tennessee-garage/dB-Sentry/assets/tiki-1.png

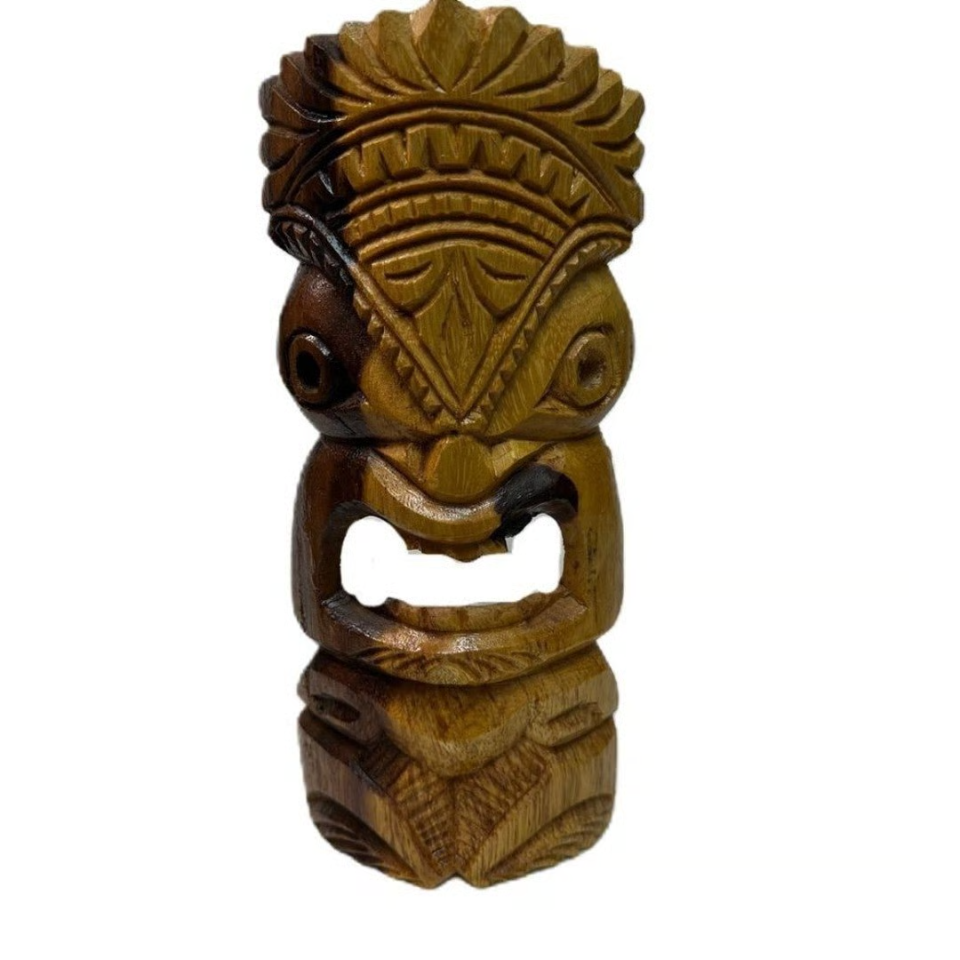
assets/tiki-1.png
