tennessee-garage/dB-Sentry/README.md

# dB-Sentry
Sound level monitoring, graphing and alerting for music events
