tennessee-garage/dB-Sentry/src/limit-service/README.md

# dB-Sentry Limit Service

A Python service for Raspberry Pi that:
- Subscribes to MQTT topics on the local broker and evaluates incoming numeric messages.
- Reads and writes limit values to InfluxDB on the Pi.
- Controls an LED strip (hardware mode) or simulates LED output (dev mode).
- Provides a simple HTTP UI to view and update 3-5 numeric limits.

Quick start

1. Install dependencies (on the Pi):

```bash
python3 -m venv venv
source venv/bin/activate
pip install -r requirements.txt
```

2. Create a `.env` file next to `main.py` with Influx/MQTT settings, e.g.:

```ini
MQTT_BROKER=localhost
MQTT_PORT=1883
MQTT_TOPIC=sensors/#
INFLUX_URL=http://localhost:8086
INFLUX_TOKEN=my-token
INFLUX_ORG=my-org
INFLUX_BUCKET=limits
LED_SIMULATE=true
LED_COUNT=30
``` 

3. Run locally:

```bash
python main.py
```

## MQTT debug CLI

Use this helper to print incoming level data from MQTT by sensor:

```bash
python monitor-levels.py
```

Useful options:

```bash
# custom connection/topic
python monitor-levels.py --broker localhost --port 1883 --topic "db_sentry/#"

# also display payloads that could not be parsed as numeric levels
python monitor-levels.py --show-unparsed
```

## Running as a systemd service

To run the service automatically on boot:

1. Install the service:

```bash
# Copy the service file to systemd
sudo cp db-sentry-limit.service /etc/systemd/system/

# Reload systemd to recognize the new service
sudo systemctl daemon-reload

# Enable the service to start on boot
sudo systemctl enable db-sentry-limit

# Start the service now
sudo systemctl start db-sentry-limit
```

2. Managing the service:

```bash
# Check status
sudo systemctl status db-sentry-limit

# View logs
sudo journalctl -u db-sentry-limit -f

# Stop the service
sudo systemctl stop db-sentry-limit

# Restart the service
sudo systemctl restart db-sentry-limit

# Disable auto-start on boot
sudo systemctl disable db-sentry-limit
```

**Note:** Make sure to update the `User`, `Group`, `WorkingDirectory`, and `ExecStart` paths in `db-sentry-limit.service` to match your system configuration before installing.

Files of interest
- `main.py` - entrypoint that starts MQTT, Influx and the web server.
- `mqtt_client.py` - MQTT subscription and message handling.
- `influx_client.py` - read/write limit values.
- `webserver.py` - FastAPI app exposing UI and update endpoints.

Notes
- InfluxDB: The project now prefers InfluxDB v1. Configure `INFLUX_HOST`, `INFLUX_PORT`, `INFLUX_USER`, `INFLUX_PASSWORD`, and `INFLUX_DB` in your `.env` to persist limits. If `INFLUX_DB` is not set or the v1 client is unavailable, the service will use an in-memory Noop client with default limits.
	The v2 `influxdb-client` settings (`INFLUX_URL`, `INFLUX_TOKEN`, `INFLUX_ORG`, `INFLUX_BUCKET`) remain in `.env.example` for legacy reference but are not used by default.
