tennessee-garage/dB-Sentry/pcb/db-collector/db-collector.step

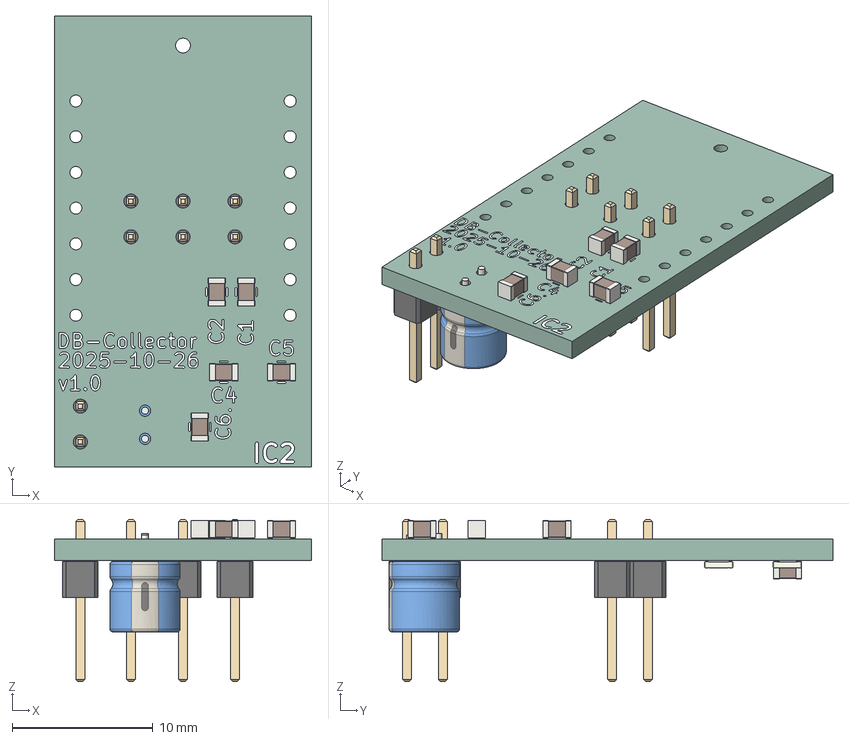
[picture p2: CAD file, 2025-12-04]
pcb/db-collector/db-collector.step
18.3 x 32.1 x 11.5 mm
C_0805_2012Metric x 6
PinHeader_1x02_P2.54mm_Vertical x 4
R_0805_2012Metric x 4
CP_Radial_D5.0mm_P2.00mm
db-collector_silkscreen
db-collector_PCB
