tennessee-garage/dB-Sentry/pcb/pi-battery-meter/pi-battery-meter.step

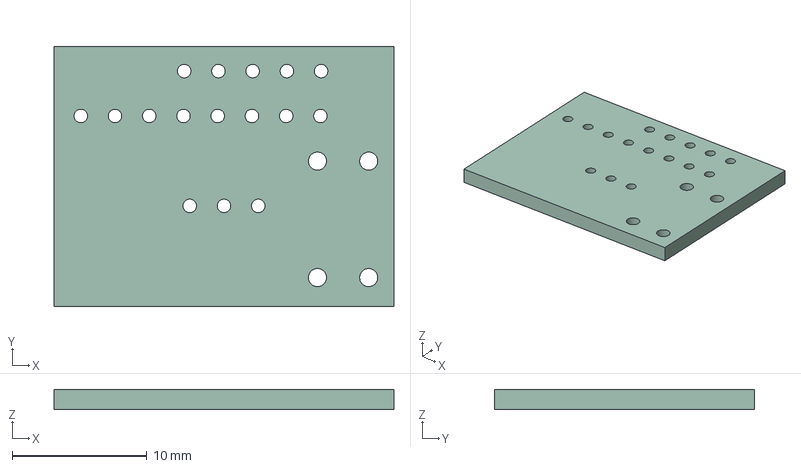
[picture p3: CAD file, 2026-04-11]
pcb/pi-battery-meter/pi-battery-meter.step
25.2 x 19.3 x 1.51 mm
