tennessee-garage/dB-Sentry/src/setup-service/IMPLEMENTATION_PLAN.md

# DB-Sentry Setup Service - Implementation Plan

## Overview
Raspberry Pi service that creates an Access Point for WiFi configuration of the DB-Sentry sensor network.

## Implementation Status: ✅ COMPLETE

### Components Implemented

#### 1. Configuration Management ✅
- **File**: `config_manager.py`
- **Settings File**: `config.json` (not tracked in git)
- **Features**:
  - AP SSID: "DB-Sentry-Setup"
  - AP Password: "not-too-loud"
  - Configurable network settings
  - JSON-based configuration

#### 2. Network Management ✅
- **File**: `network_manager.py`
- **Features**:
  - Start/stop AP mode using hostapd + dnsmasq
  - WiFi network scanning (nmcli + iwlist fallback)
  - Connect to WiFi networks
  - Network interface management

#### 3. API Endpoints ✅
- **File**: `app.py`
- **Endpoints**:
  - `POST /api/start-ap` - Enable AP mode
  - `POST /api/stop-ap` - Disable AP and connect to WiFi
  - `GET /api/scan-networks` - Scan for WiFi networks
  - `POST /api/configure-wifi` - Set WiFi credentials
  - `POST /api/sensor-register` - Register sensor and provide WiFi info
  - `GET /api/sensors` - List connected sensors
  - `GET /api/status` - Current setup status
  - `POST /api/reset` - Reset setup process

#### 4. Web Interface ✅
- **Files**: 
  - `templates/setup.html`
  - `static/style.css`
  - `static/script.js`
- **Features**:
  - Multi-step wizard interface
  - Network scanning and selection
  - Password entry
  - Real-time sensor registration display
  - Responsive design
  - Auto-refresh for sensor updates

#### 5. State Management ✅
- Tracks AP mode status
- Stores selected WiFi credentials
- Maintains list of connected sensors
- Setup completion tracking

## User Workflow

### Step 1: Start AP Mode
```bash
curl -X POST http://localhost:5000/api/start-ap
```

### Step 2: Connect to AP
- SSID: `DB-Sentry-Setup`
- Password: `not-too-loud`

### Step 3: Access Setup Page
- Navigate to: `http://192.168.4.1:5000`

### Step 4: Configure WiFi
1. Scan for networks
2. Select target WiFi
3. Enter password
4. Confirm

### Step 5: Register Sensors
Sensors make API call:
```python
response = requests.post('http://192.168.4.1:5000/api/sensor-register',
    json={'name': 'sensor-01'})
wifi_credentials = response.json()
```

### Step 6: Complete Setup
- Finish button stops AP
- Pi connects to configured WiFi
- System ready

## System Requirements

### Software
- Python 3.7+
- Flask 3.0.0
- flask-cors 4.0.0
- hostapd
- dnsmasq
- NetworkManager (nmcli)

### Hardware
- Raspberry Pi with WiFi
- WiFi adapter supporting AP mode

## Installation Steps

1. Install system packages:
```bash
sudo apt-get install hostapd dnsmasq python3-pip network-manager
```

2. Install Python dependencies:
```bash
pip3 install -r requirements.txt
```

3. Configure settings in `config.json`

4. Run service:
```bash
python3 app.py
```

## Security Notes

- `config.json` excluded from git via `.gitignore`
- AP password configurable
- WiFi credentials transmitted only over local network
- AP mode temporary (only during setup)

## Testing Checklist

- [ ] AP mode starts successfully
- [ ] Mobile device can connect to AP
- [ ] Setup page loads and displays correctly
- [ ] Network scan returns available WiFi
- [ ] WiFi credentials can be configured
- [ ] Sensors can register and receive credentials
- [ ] Setup completion stops AP
- [ ] Pi connects to configured WiFi

## Future Enhancements

- [ ] HTTPS support for setup page
- [ ] Sensor authentication tokens
- [ ] Multiple WiFi profile support
- [ ] Scheduled AP mode activation
- [ ] Email/SMS notifications
- [ ] Backup WiFi configuration
- [ ] Web UI for starting AP mode
- [ ] QR code for WiFi credentials

## Files Created

```
db-sentry-setup/
├── .gitignore              # Git ignore rules
├── README.md               # Documentation
├── IMPLEMENTATION_PLAN.md  # This file
├── app.py                  # Main Flask application
├── config.json            # Configuration (not in git)
├── config_manager.py      # Config management
├── network_manager.py     # Network utilities
├── requirements.txt       # Python dependencies
├── templates/
│   └── setup.html        # Web interface
└── static/
    ├── style.css         # Styles
    └── script.js         # Frontend JavaScript
```

## Notes

- Service runs on port 5000 by default
- AP IP: 192.168.4.1
- DHCP range: 192.168.4.2 - 192.168.4.20
- All settings configurable via config.json
