tennessee-garage/dB-Sentry/pcb/batt-interface/batt-interface.kicad_pcb

## KiCad design pcb/batt-interface/batt-interface.kicad_pcb (2026-10-09)

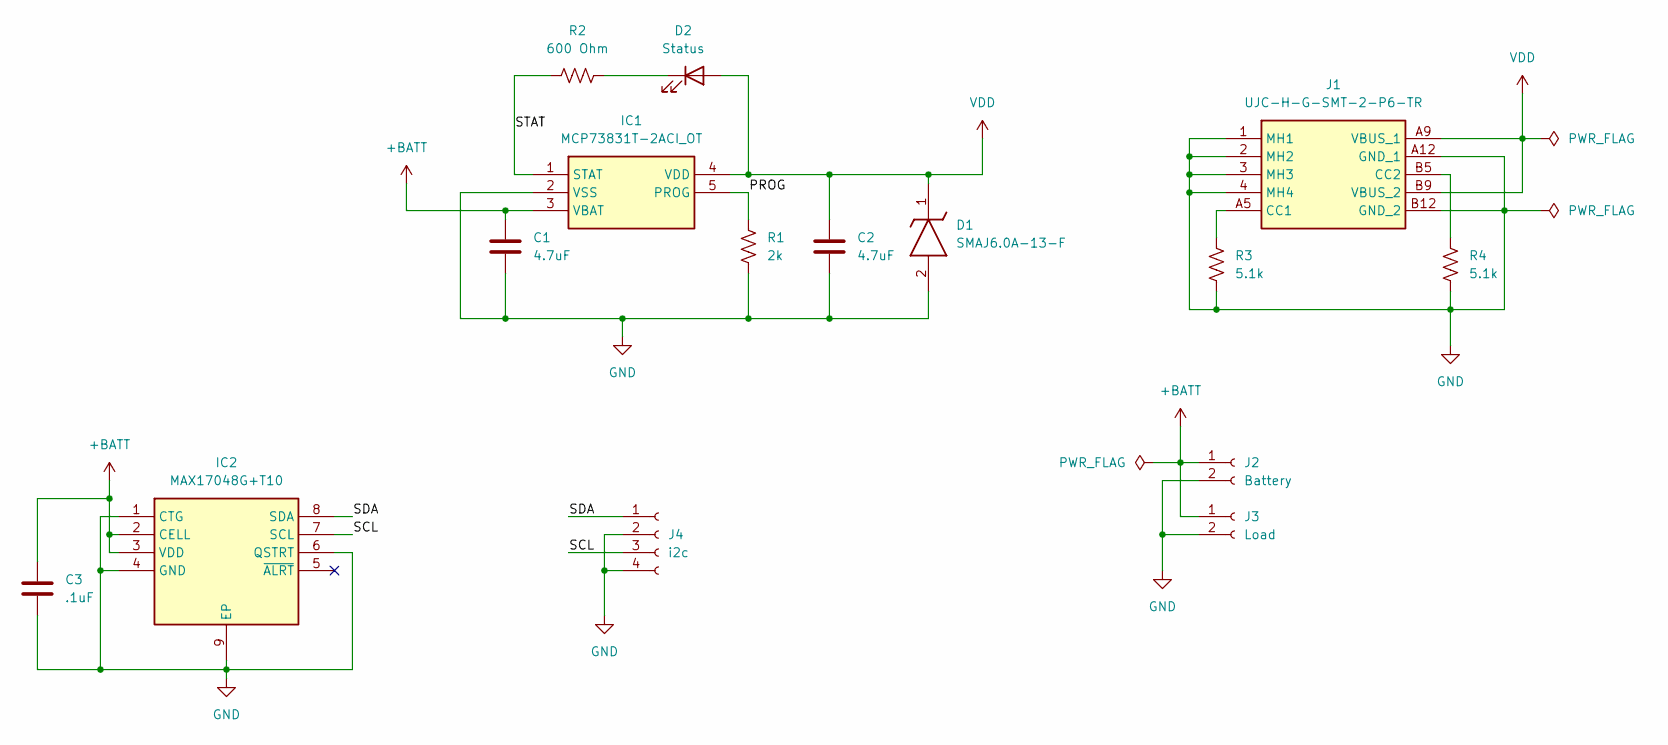
[picture p4: schematic batt-interface.kicad_sch]

Parts:
C1, C2: 4.7uF; C_0805_2012Metric_Pad1.18x1.45mm_HandSolder
C3: .1uF; C_0805_2012Metric_Pad1.18x1.45mm_HandSolder
D1: SMAJ6.0A-13-F; DIOM5226X240N; Mouser Part Number 621-SMAJ6.0A-13-F
D2: Status; LED_0805_2012Metric_Pad1.15x1.40mm_HandSolder
IC1: MCP73831T-2ACI_OT; SOT95P270X145-5N; Mouser Part Number 579-MCP73831T-2ACIOT
IC2: MAX17048G+T10; SON50P200X200X80-9N-D; Mouser Part Number 700-MAX17048G+T10
J1: UJC-H-G-SMT-2-P6-TR; UJCHGSMT2P6TR; Mouser Part Number 179-UJCHGSMT2P6TR
J2: Battery; JST_PH_S2B-PH-K_1x02_P2.00mm_Horizontal
J3: Load; JST_PH_S2B-PH-K_1x02_P2.00mm_Horizontal
J4: i2c; PinHeader_1x04_P2.54mm_Vertical
R1: 2k; R_0805_2012Metric_Pad1.20x1.40mm_HandSolder
R2: 600 Ohm; R_0805_2012Metric_Pad1.20x1.40mm_HandSolder
R3, R4: 5.1k; R_0805_2012Metric_Pad1.20x1.40mm_HandSolder

Connections:
+BATT: C1.1, C3.1, IC1.3 (VBAT), IC2.2 (CELL), IC2.3 (VDD), J2.1, J3.1
/PROG: IC1.5 (PROG), R1.1
/SCL: IC2.7 (SCL), J4.3
/SDA: IC2.8 (SDA), J4.1
/STAT: IC1.1 (STAT), R2.1
GND: C1.2, C2.2, C3.2, D1.2 (A), IC1.2 (VSS), IC2.1 (CTG), IC2.4 (GND), IC2.6 (QSTRT), IC2.9 (EP), J1.1 (MH1), J1.2 (MH2), J1.3 (MH3), J1.4 (MH4), J1.A12 (GND_1), J1.B12 (GND_2), J2.2, J3.2, J4.2, J4.4, R1.2, R3.2, R4.2
unnamed: D2.1 (K), R2.2
unnamed: J1.A5 (CC1), R3.1
unnamed: J1.B5 (CC2), R4.1
VDD: C2.1, D1.1 (K), D2.2 (A), IC1.4 (VDD), J1.A9 (VBUS_1), J1.B9 (VBUS_2)

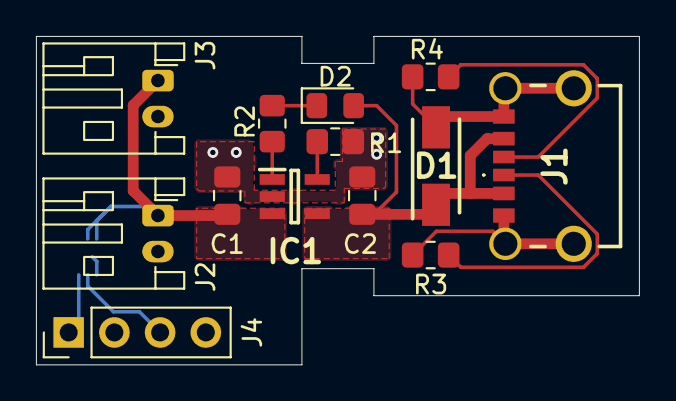
[picture p5: board batt-interface.kicad_pcb from above]

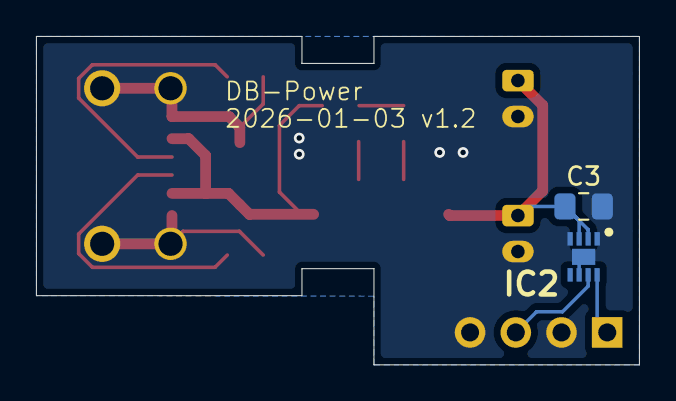
[picture p6: board batt-interface.kicad_pcb from below]

Board: 2 copper layers, 33.5 x 18.2 mm, 15 parts (2 on the bottom side), 10 nets.
