tennessee-garage/dB-Sentry/pcb/pi-shield/pi-shield.kicad_pcb

## KiCad design pcb/pi-shield/pi-shield.kicad_pcb (2026-04-30)

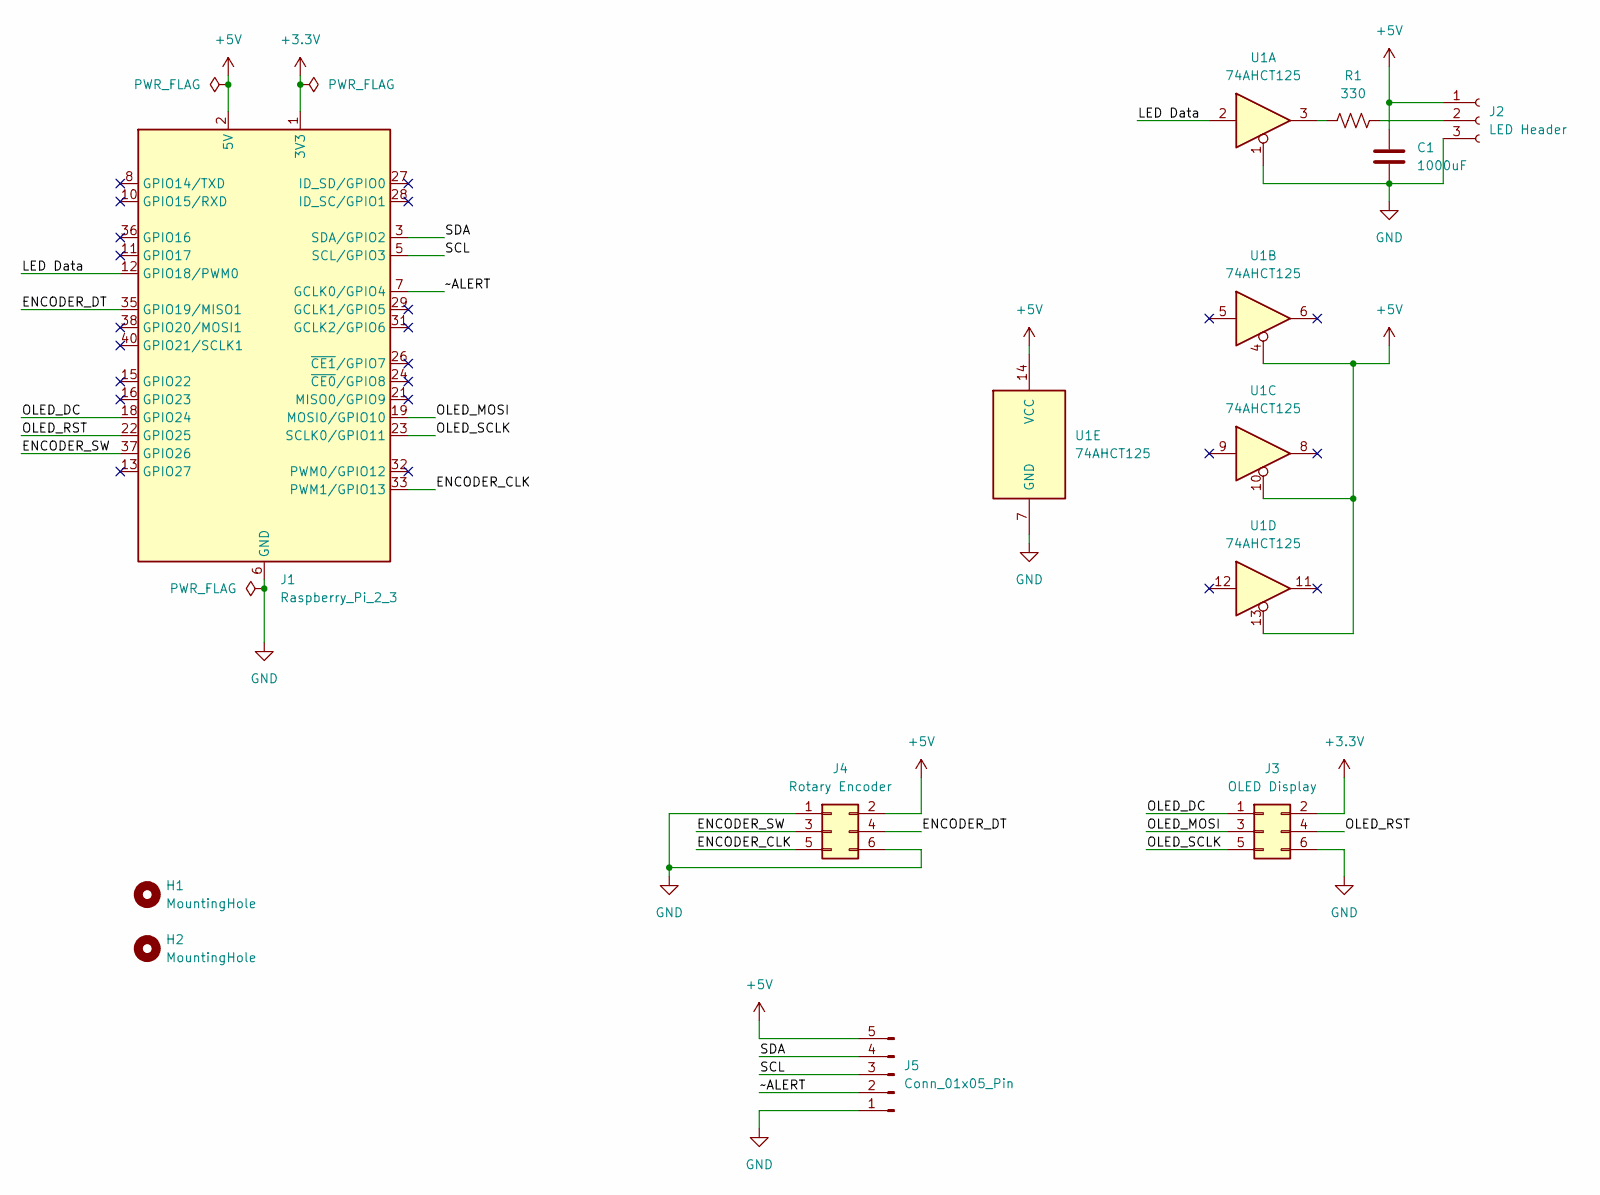
[picture p7: schematic pi-shield.kicad_sch]

Parts:
C1: 1000uF; C_Radial_D10.0mm_H16.0mm_P5.00mm
H1, H2: MountingHole; MountingHole_2.7mm_M2.5
J1: Raspberry_Pi_2_3; PinSocket_2x20_P2.54mm_Vertical
J2: LED Header; PinHeader_1x03_P2.54mm_Vertical
J3: OLED Display; PinHeader_2x03_P2.54mm_Vertical
J4: Rotary Encoder; PinHeader_2x03_P2.54mm_Vertical
J5: Conn_01x05_Pin; PinHeader_1x05_P2.54mm_Vertical
R1: 330; R_0805_2012Metric_Pad1.20x1.40mm_HandSolder
U1: 74AHCT125; TSSOP-14_4.4x5mm_P0.65mm

Connections:
+3.3V: J1.1 (3V3), J1.17 (3V3), J3.2
+5V: C1.1, J1.2 (5V), J1.4 (5V), J2.1, J4.2, J5.5, U1.4, U1.10, U1.13, U1.14 (VCC)
/ENCODER_CLK: J1.33 (PWM1/GPIO13), J4.5
/ENCODER_DT: J1.35 (GPIO19/MISO1), J4.4
/ENCODER_SW: J1.37 (GPIO26), J4.3
/LED Data: J1.12 (GPIO18/PWM0), U1.2
/OLED_DC: J1.18 (GPIO24), J3.1
/OLED_MOSI: J1.19 (MOSI0/GPIO10), J3.3
/OLED_RST: J1.22 (GPIO25), J3.4
/OLED_SCLK: J1.23 (SCLK0/GPIO11), J3.5
/SCL: J1.5 (SCL/GPIO3), J5.3
/SDA: J1.3 (SDA/GPIO2), J5.4
/~ALERT: J1.7 (GCLK0/GPIO4), J5.2
GND: C1.2, J1.6 (GND), J1.9 (GND), J1.14 (GND), J1.20 (GND), J1.25 (GND), J1.30 (GND), J1.34 (GND), J1.39 (GND), J2.3, J3.6, J4.1, J4.6, J5.1, U1.1, U1.7 (GND)
unnamed: J2.2, R1.2
unnamed: R1.1, U1.3

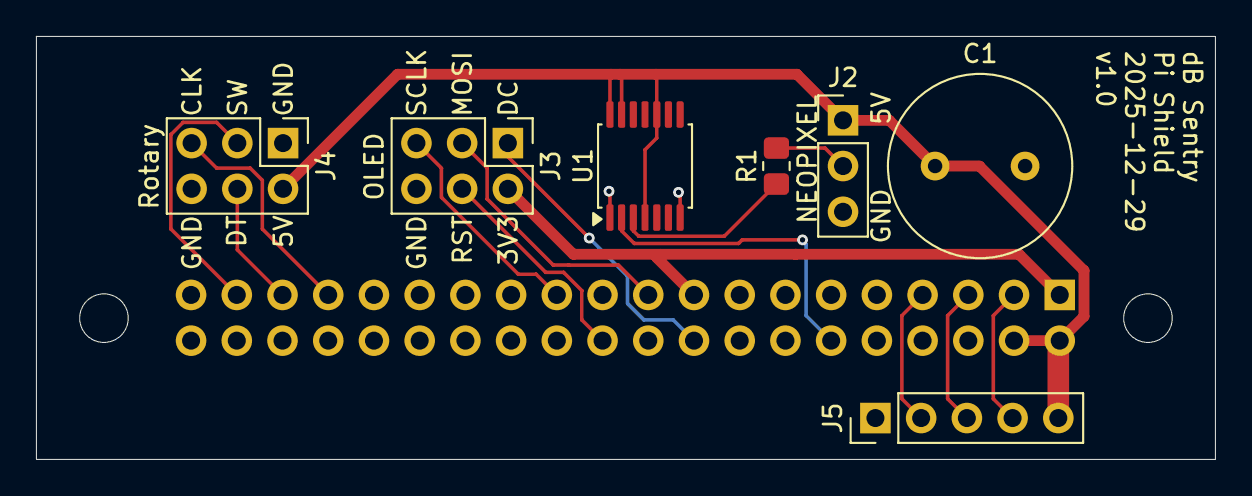
[picture p8: board pi-shield.kicad_pcb from above]

Board: 2 copper layers, 65.5 x 23.5 mm, 10 parts (1 on the bottom side), 16 nets.
