tennessee-garage/dB-Sentry/pcb/pi-battery-meter/pi-battery-meter.kicad_pcb

## KiCad design pcb/pi-battery-meter/pi-battery-meter.kicad_pcb (2026-04-11)

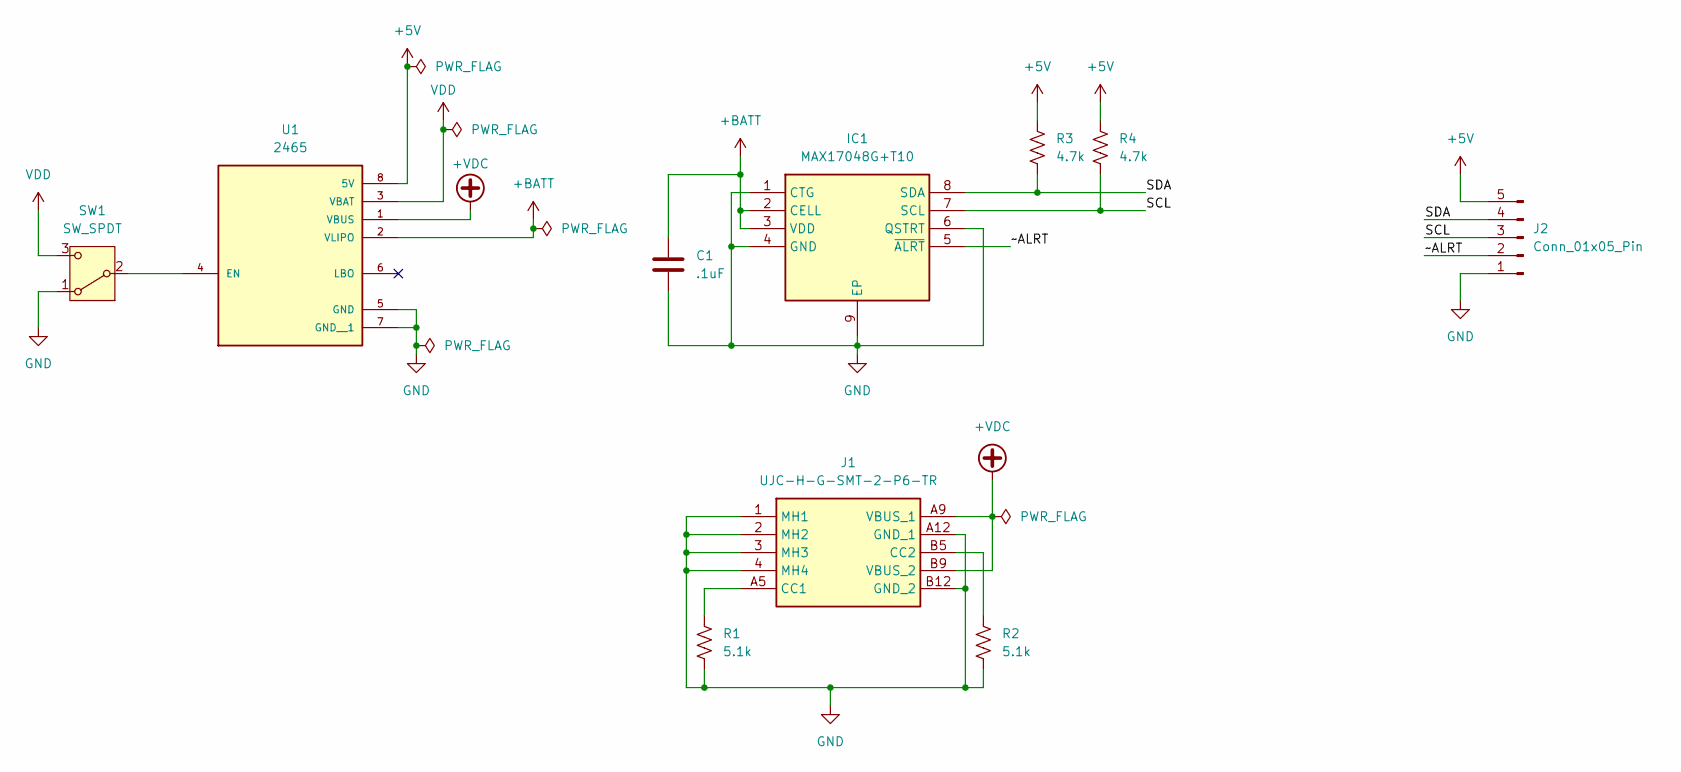
[picture p9: schematic pi-battery-meter.kicad_sch]

Parts:
C1: .1uF; C_0805_2012Metric_Pad1.18x1.45mm_HandSolder
IC1: MAX17048G+T10; SON50P200X200X80-9N-D; Mouser Part Number 700-MAX17048G+T10
J1: UJC-H-G-SMT-2-P6-TR; UJCHGSMT2P6TR; Mouser Part Number 179-UJCHGSMT2P6TR
J2: Conn_01x05_Pin; PinHeader_1x05_P2.54mm_Vertical
R1, R2: 5.1k; R_0805_2012Metric_Pad1.20x1.40mm_HandSolder
R3, R4: 4.7k; R_0805_2012Metric_Pad1.20x1.40mm_HandSolder
SW1: SW_SPDT; PinHeader_1x03_P2.54mm_Vertical
U1: 2465; MODULE_2465_NO_PTH; PARTREV B

Connections:
+5V: J2.5, R3.1, R4.1, U1.8 (5V)
+BATT: C1.1, IC1.2 (CELL), IC1.3 (VDD), U1.2 (VLIPO)
+VDC: J1.A9 (VBUS_1), J1.B9 (VBUS_2), U1.1 (VBUS)
/SCL: IC1.7 (SCL), J2.3, R4.2
/SDA: IC1.8 (SDA), J2.4, R3.2
/~ALRT: IC1.5 (~ALRT), J2.2
GND: C1.2, IC1.1 (CTG), IC1.4 (GND), IC1.6 (QSTRT), IC1.9 (EP), J1.1 (MH1), J1.2 (MH2), J1.3 (MH3), J1.4 (MH4), J1.A12 (GND_1), J1.B12 (GND_2), J2.1, R1.2, R2.2, SW1.1 (A), U1.5 (GND), U1.7 (GND__1)
unnamed: J1.A5 (CC1), R1.1
unnamed: J1.B5 (CC2), R2.1
unnamed: SW1.2 (B), U1.4 (EN)
VDD: SW1.3 (C), U1.3 (VBAT)

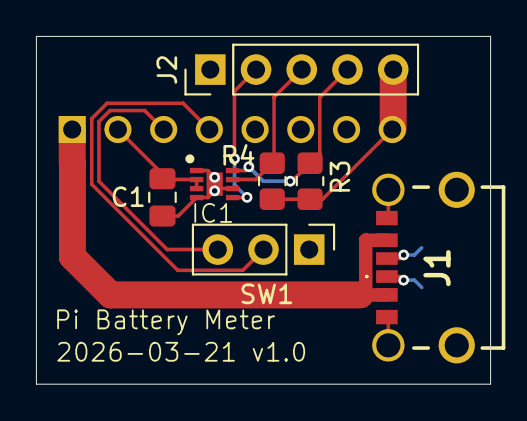
[picture p10: board pi-battery-meter.kicad_pcb from above]

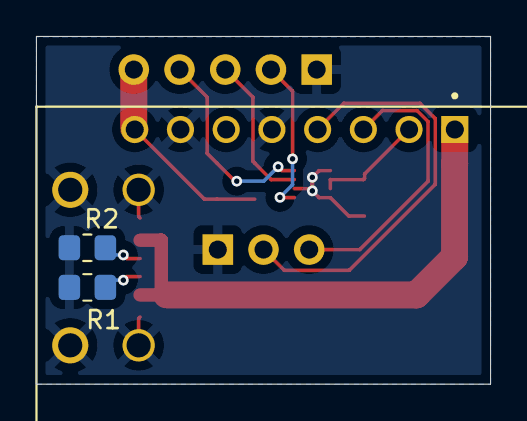
[picture p11: board pi-battery-meter.kicad_pcb from below]

Board: 2 copper layers, 25.2 x 19.3 mm, 10 parts (3 on the bottom side), 11 nets.
