tennessee-garage/dB-Sentry/pcb/db-collector/db-collector.kicad_pcb

## KiCad design pcb/db-collector/db-collector.kicad_pcb (2025-12-24)

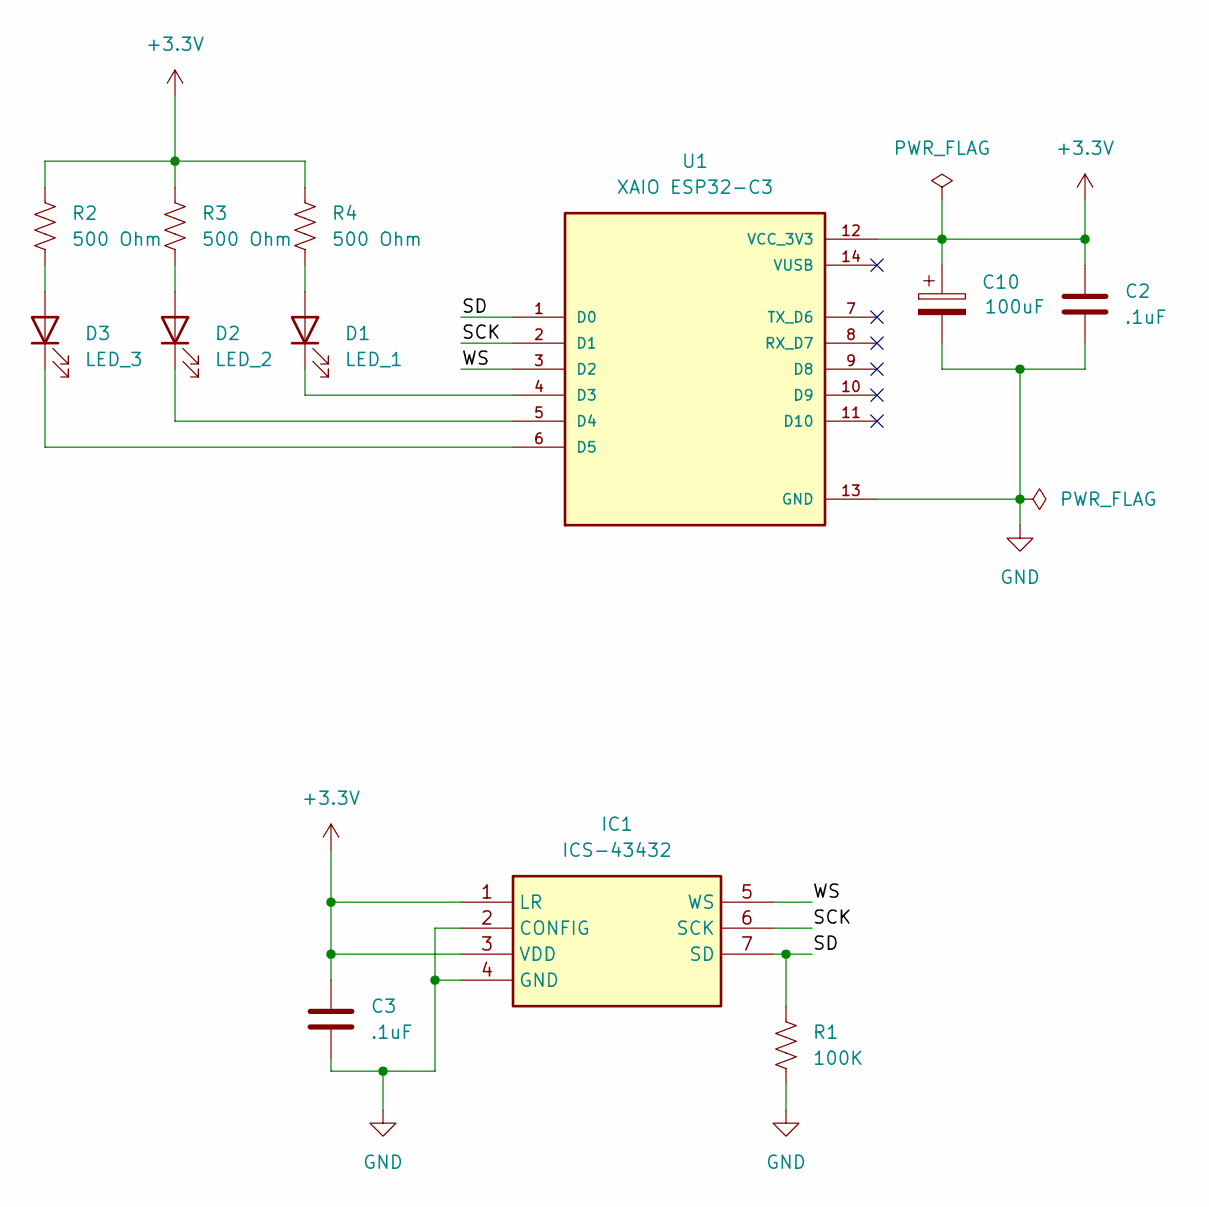
[picture p12: schematic db-collector.kicad_sch]

Parts:
C2, C3: .1uF; C_0805_2012Metric_Pad1.18x1.45mm_HandSolder
C10: 100uF; CP_Radial_D5.0mm_P2.00mm
D1: LED_1; PinHeader_1x02_P2.54mm_Vertical
D2: LED_2; PinHeader_1x02_P2.54mm_Vertical
D3: LED_3; PinHeader_1x02_P2.54mm_Vertical
IC1: ICS-43432; ICS43432; Mouser Part Number 410-ICS-43432
R1: 100K; R_0805_2012Metric_Pad1.20x1.40mm_HandSolder
R2, R3, R4: 500 Ohm; R_0805_2012Metric_Pad1.20x1.40mm_HandSolder
U1: XAIO ESP32-C3; MODULE_113991054; PARTREV 23/05/2022

Connections:
+3.3V: C2.1, C3.1, C10.1, IC1.1 (LR), IC1.3 (VDD), R2.1, R3.1, R4.1, U1.12 (VCC_3V3)
/SCK: IC1.6 (SCK), U1.2 (D1)
/SD: IC1.7 (SD), R1.1, U1.1 (D0)
/WS: IC1.5 (WS), U1.3 (D2)
GND: C2.2, C3.2, C10.2, IC1.2 (CONFIG), IC1.4 (GND), R1.2, U1.13 (GND)
unnamed: D1.2 (A), R4.2
unnamed: D1.1 (K), U1.4 (D3)
unnamed: D2.2 (A), R3.2
unnamed: D2.1 (K), U1.5 (D4)
unnamed: D3.2 (A), R2.2
unnamed: D3.1 (K), U1.6 (D5)

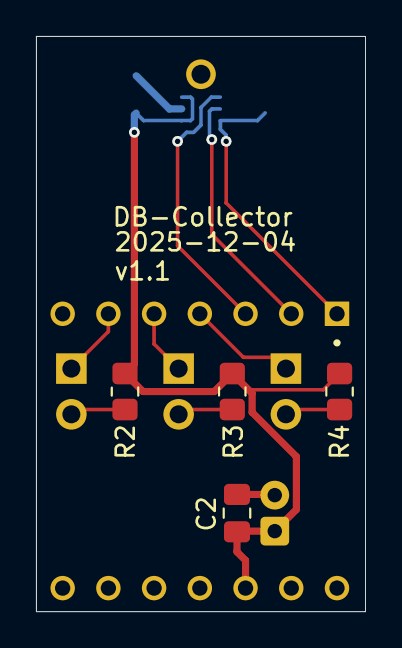
[picture p13: board db-collector.kicad_pcb from above]

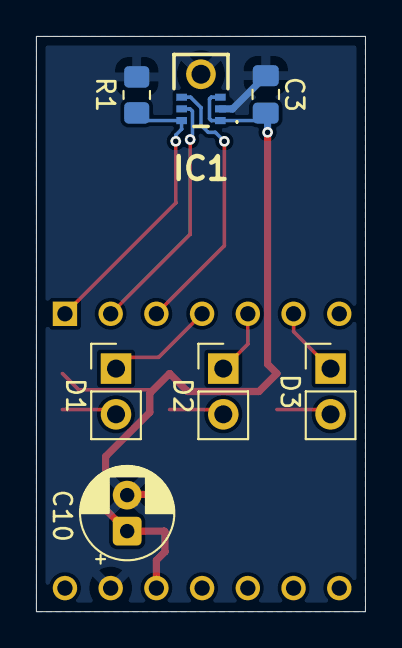
[picture p14: board db-collector.kicad_pcb from below]

Board: 2 copper layers, 18.3 x 32.0 mm, 12 parts (7 on the bottom side), 11 nets.
