tennessee-garage/dB-Sentry/src/db-sentry/src/experiments/adafruit-sample-code.cpp

/*
 This example reads audio data from an I2S microphone
 breakout board, and prints out the samples to the Serial console. The
 Serial Plotter built into the Arduino IDE can be used to plot the audio
 data (Tools -> Serial Plotter)

 Circuit:
 * Arduino/Genuino Zero, MKRZero or MKR1000 board
   * GND connected GND
   * 3.3V connected 3.3V (Zero) or VCC (MKR1000, MKRZero)
   * WS connected to pin 0 (Zero) or pin 3 (MKR1000, MKRZero)
   * CLK connected to pin 1 (Zero) or pin 2 (MKR1000, MKRZero)
   * SD connected to pin 9 (Zero) or pin A6 (MKR1000, MKRZero)

 created 17 November 2016
 by Sandeep Mistry
 */

#include <I2S.h>

const int I2S_WS_PIN  = D2;   // LRCLK / WS
const int I2S_SCK_PIN = D1;   // BCLK / SCK
const int I2S_SD_PIN  = D0;   // SD (data from mic)

void setup() {
	// Open serial communications and wait for port to open:
	// A baud rate of 115200 is used instead of 9600 for a faster data rate
	// on non-native USB ports
	Serial.begin(115200);
	while (!Serial) {
		; // wait for serial port to connect. Needed for native USB port only
	}

	I2S.setDataPin(I2S_SD_PIN);
	I2S.setSckPin(I2S_SCK_PIN);
	I2S.setFsPin(I2S_WS_PIN);

	// start I2S at 16 kHz with 32-bits per sample
	if (!I2S.begin(I2S_PHILIPS_MODE, 16000, 32)) {
		Serial.println("Failed to initialize I2S!");
		while (1); // do nothing
	}
}

void loop() {
	// read a sample
	int sample = I2S.read();

	if ((sample == 0) || (sample == -1) ) {
		return;
	}
	// convert to 18 bit signed
	sample >>= 14; 

	// if it's non-zero print value to serial
	Serial.printf(">wave:%d\n", sample);
}
