tennessee-garage/dB-Sentry/(commit log)

2025-10-27 First versions of battery board and monitor board
    [batt-interface.kicad_pcb, batt-interface.kicad_sch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]
2025-12-01 First version of python code that monitors the sensor data and alerts
2025-12-01 Correct the topic. Also remove extraneous influxdb connect
    [config.py]
2025-12-04 Commiting v1 of this design before making changes for a v2
    Changes in this commit are limited to simple UI view changes, not substantive
    [db-collector.step]
2025-12-07 Make sure we inlude all active sensors in the setting list, and give a default value if they haven't been configured yet.
2025-12-24 Updates to support reading from an encoder
2025-12-24 New simplified db-collector. Big change is that the battery attaches directly to the ESP32-c3 XIAO battery terminals and lets it do the voltage regulation. This gets around how finicky the ESP is to 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
    [db-collector.kicad_pcb, db-collector.kicad_sch]
2025-12-24 Try to get SPI running faster
2025-12-24 Added in support to cache a menu rendering (the font rendering was taking 25ms per line). Also some test scripts that demonstrate a menu, and then one that combines the encoder to control the menu.
2025-12-24 Simplified the oled driver and removed all the animation/easing stuff for scrolling. Also simplified the indexing into the menu cache
2025-12-24 Forgot about the changes to menu.py that support the previous commit. This is primarily the better indexing into the pre-cached frames.
2026-01-03 Added pull down resistors for CC1 and CC2 to ensure proper charging.
    [batt-interface.kicad_pcb, batt-interface.kicad_sch]
2026-01-04 Add in support for the status LEDs
2026-01-04 First version of the OLED adapter board and the Raspberry Pi shield. These work together to Connect the OLED screen to the Pi, plus a way to connect a rotary encoder.
    [oled-adapter.kicad_pcb, oled-adapter.kicad_sch, pi-shield.kicad_pcb, pi-shield.kicad_sch]
2026-01-27 Moving out code for encoder and OLED and leds to a new service
2026-01-27 Fixed some signature errors.
    [test_dynamic_menu.py]
2026-01-27 Fix some menu issues
    [dynamic_menu.py, main.py, oled_display.py, sentry_hub_interface.py]
2026-01-28 Fix menu live updates and change the brightness settings to be a bar vs number.
    [dynamic_menu.py, menu.py]
2026-01-29 Add control for the LED here, and provide an IPC server for the limit-service to connect to us to set warnings/alerts.
2026-01-29 Make the led brightness control work with active feedback from the leds
2026-01-29 Dont' show me errors for this import on a mac
    [neopixel_pattern_demo.py]
2026-01-30 Updated to remove old LED, OLED and encoder interface stuff which is now in the interface-service.
2026-01-31 Allow the limit-service to update the LEDs with status
2026-01-31 Get rid of LED settings
2026-02-01 Add an IPC to sent sensor information to the interface
2026-02-01 Some small visual fixes.
    [dynamic_menu.py]
2026-02-01 Make sure the back button works on dynamic menus
2026-02-01 Don't keep the sensor status display hung at the last known value start showing blank when they're offline.
2026-02-03 Keep track of the last time a sensor sent data, and remove it if its been too long.
2026-02-04 Several changes * Got a more readable font * Displaying 3 lines up now * Adjusted how submenus display * Added methods to the limit-service webserver to allow the interface-service to call it * made 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
2026-02-05 Made all data transfer needed for the OLED menus rely on the limit service webserver API. Anything for updating the LED status bar is from the limit service to the interface service via the IPC servi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
2026-02-07 Allow adding more readable sensor names, while still making it easy to upload new code to any sensor.
2026-02-07 Move this service earlier in the stack so that the OLED power up. Then show booting text until the limit-service comes online
2026-02-17 Completed setup mode that allows adding WiFi credentials that the Pi and the sensors can use.
2026-02-17 Changes so that the sensors can connect to the db-sentry-hub for setup and for operation.
2026-02-18 Add a reset wifi option in case we need to have it rescan.
    [dynamic_menu.py]
2026-04-11 Add the pi battery meter board
    [pi-battery-meter.kicad_pcb, pi-battery-meter.kicad_sch, pi-battery-meter.step]
2026-04-30 Adding some images and models for the sentry enclosures
2026-04-30 Add support for reading the battery level, voltage and charge rate.
2026-04-30 Fix problem with screen cut off when orientation is to the right.
    [oled_display.py]
2026-04-30 Several KiCad changes (ngl, not sure what changed here)
    [pi-shield.kicad_pcb, pi-shield.kicad_sch]
2026-05-02 Use a rolling window average of the discharge rate to estimate time left so that quick jumps up or down don't make it so twitchy.
    [dynamic_menu.py, max17048_fuel_gauge.py]
2026-05-02 Add a capacity graph that has a 128 minute history (1 reading per minute per horizontal screen pixel)
2026-05-02 Remove y-axis labels and get the font cleaned up
2026-05-02 Decouple battery stat collection from the display menu and slow down menu sampling in general to avoid lockups.
    [dynamic_menu.py, max17048_fuel_gauge.py, sentry_hub_interface.py]
2026-05-02 Make exiting out of the battery graph more consistent
2026-05-02 Remove retention policy for window_seconds and sensor limits
2026-10-09 Speed up hub boot so the display menu is ready ~25s sooner
    The menu waits on limit-service, which was ordered after influxdb, which waited
    for network-online and then spent ~18s more starting up. Menu now loads ~22s after
    kernel start instead of ~48s.
    - limit-service no longer waits for influxdb/mosquitto to start; it waits for
    InfluxDB to answer a ping and retries the MQTT connection instead, so its slow
    Python imports overlap their startup.
    - pi-setup-notes: InfluxDB start script/unit that skip the unused TSI rebuild and
    the network-online wait, config to stop storing _internal stats (whose WAL took
    ~10s to replay), boot-only CPU/IO priority drop-ins for grafana and telegraf,
    an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
    [main.py]
2026-10-09 Check in changes to the PCB files. Also checkin main.cpp change to clarify LED colors of status lights
    [batt-interface.kicad_pcb, batt-interface.kicad_sch]
